SamyWarnants/Display-Project/Images/boardpic1.jpg

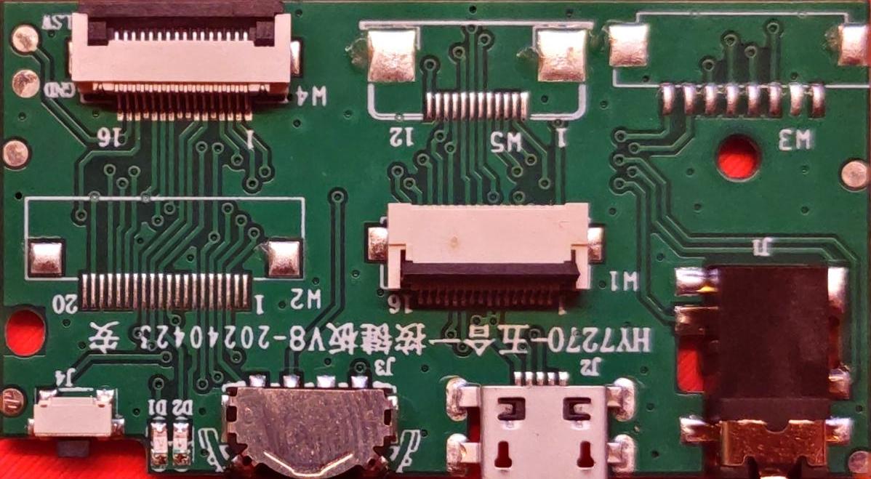
Images/boardpic1.jpg
