SamyWarnants/Display-Project/Images/boardtranslation.png

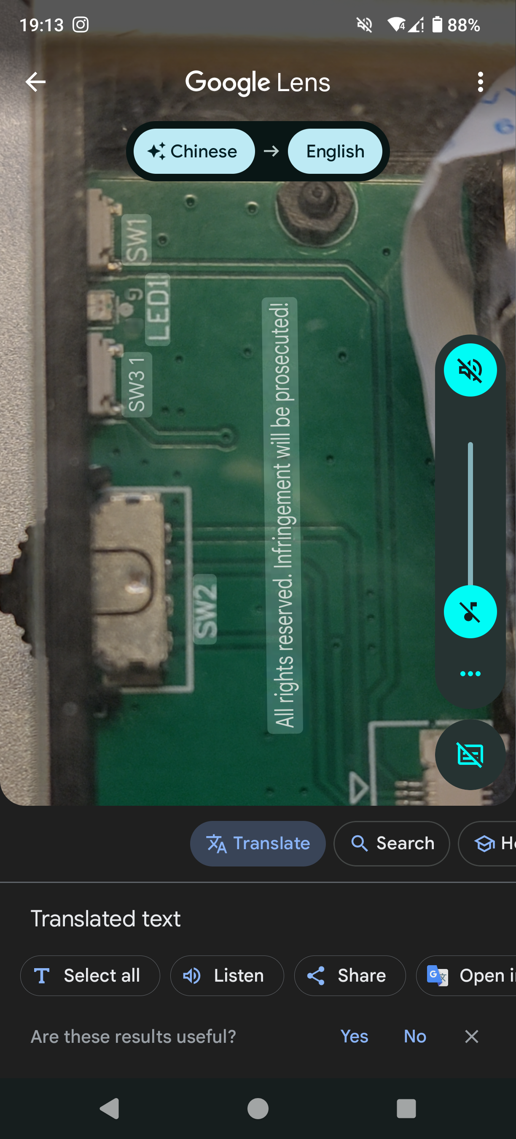
Images/boardtranslation.png
