SamyWarnants/Display-Project/Images/eindresultaatgen2.jpg

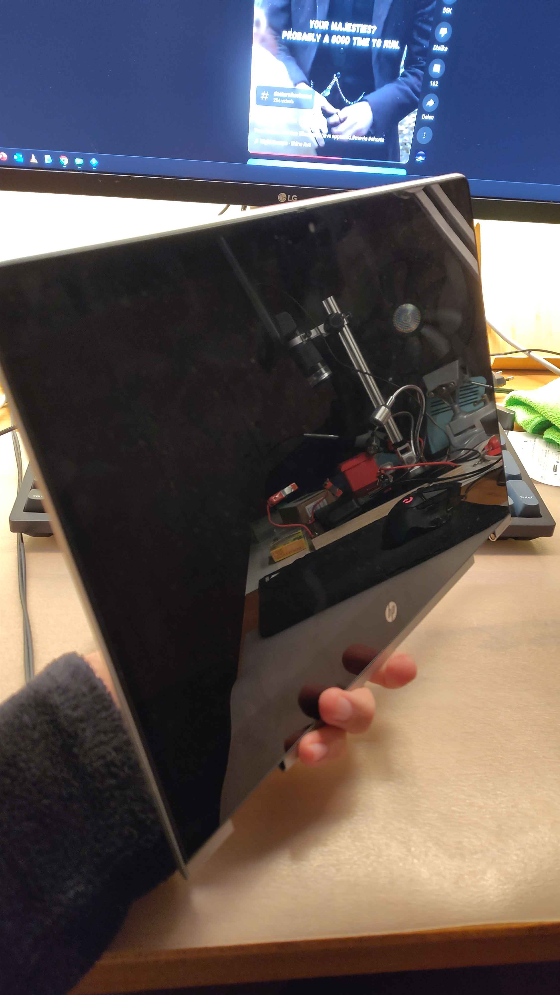
Images/eindresultaatgen2.jpg
