SamyWarnants/Display-Project/Images/missingping.jpg

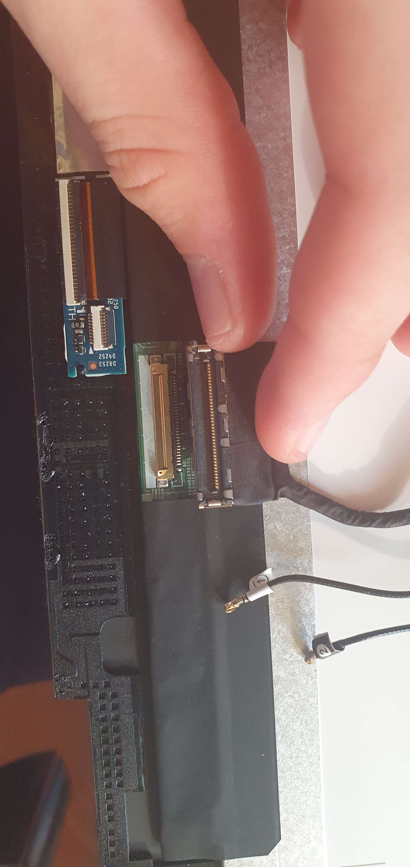
Images/missingping.jpg
