SamyWarnants/Display-Project/Images/plexialternative.jpg

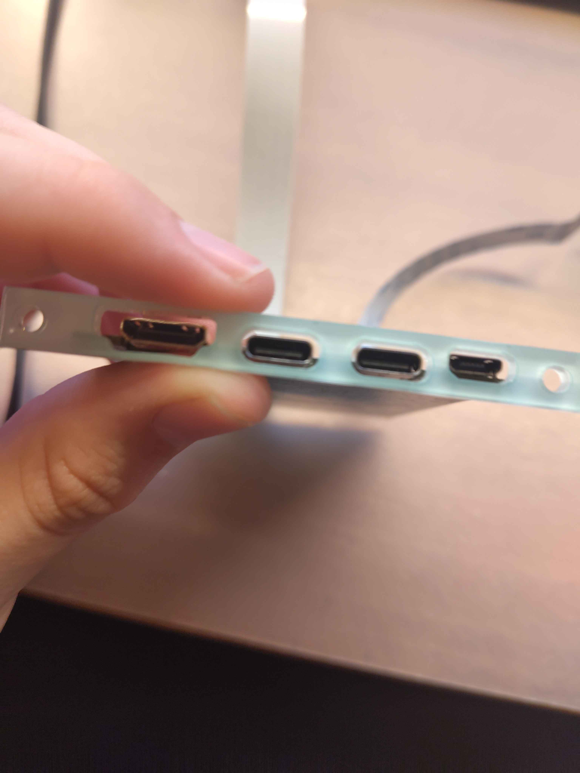
Images/plexialternative.jpg
