SamyWarnants/Display-Project/Generation1/adjustmentsysteem.3mf

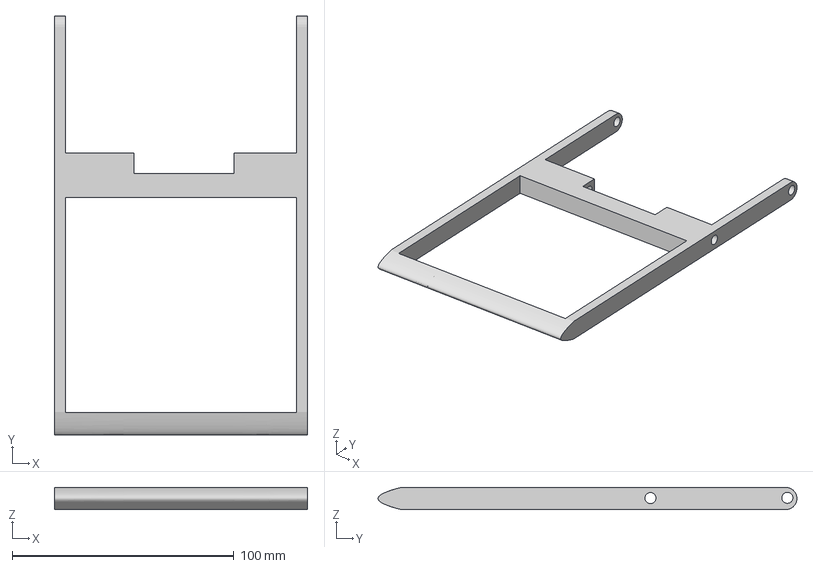
[picture p9: CAD file, 2025-09-27]
Generation1/adjustmentsysteem.3mf
114.1 x 188.9 x 10.0 mm
