SamyWarnants/Display-Project/Generation2/screenadjustmentv3.3mf

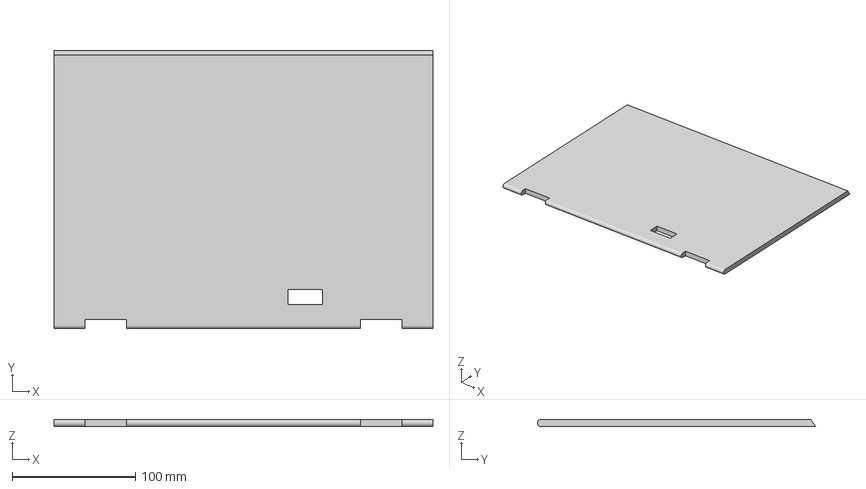
[picture p10: CAD file, 2025-09-27]
Generation2/screenadjustmentv3.3mf
307.0 x 225.5 x 5.82 mm
