SamyWarnants/Display-Project/Generation1/penholder.3mf

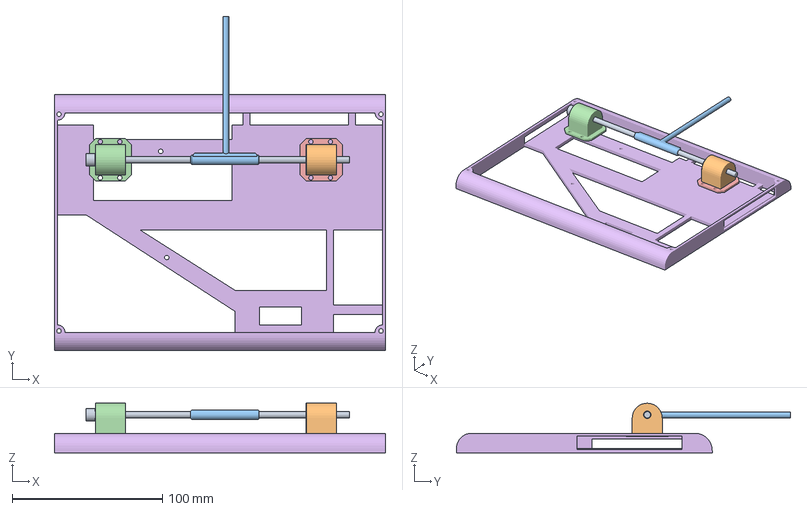
[picture p11: CAD file, 2025-09-27]
Generation1/penholder.3mf
220.0 x 222.0 x 33.0 mm
