SamyWarnants/Display-Project/Generation2/handle.3mf

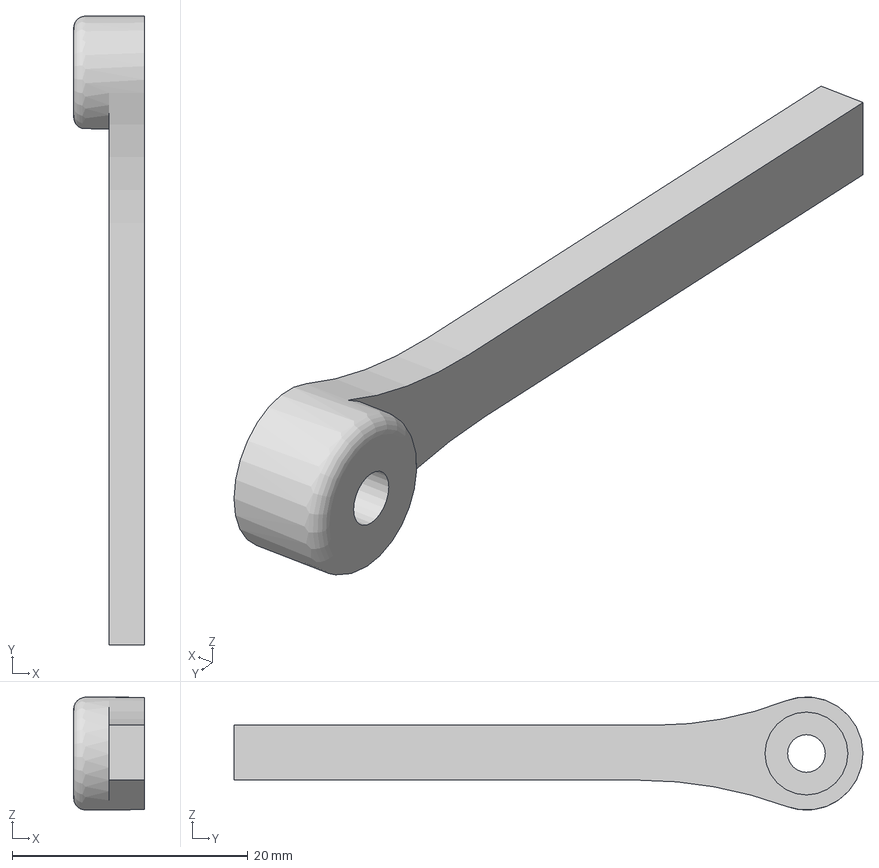
[picture p12: CAD file, 2025-09-27]
Generation2/handle.3mf
6.00 x 53.4 x 9.58 mm
