SamyWarnants/Display-Project/Generation1/magnethouderpoging2.3mf

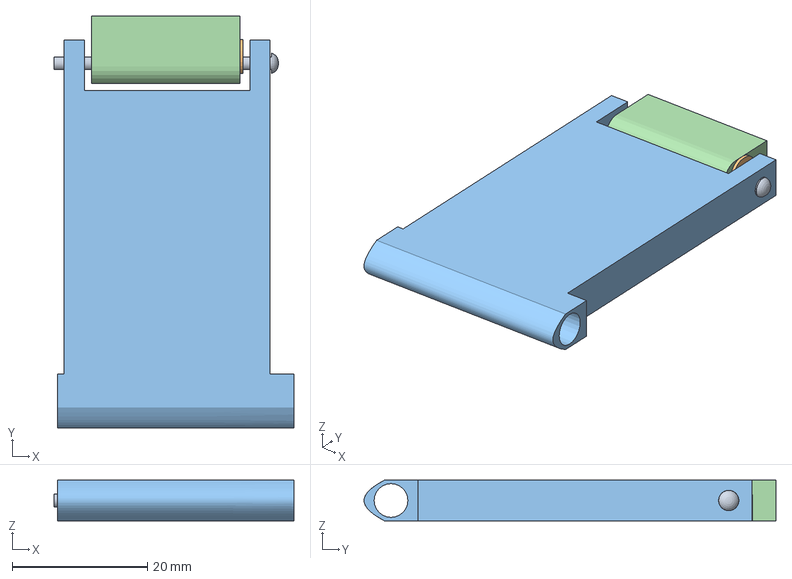
[picture p13: CAD file, 2025-09-27]
Generation1/magnethouderpoging2.3mf
35.5 x 61.0 x 6.00 mm
