SamyWarnants/Display-Project/Generation2/Hingetest.3mf

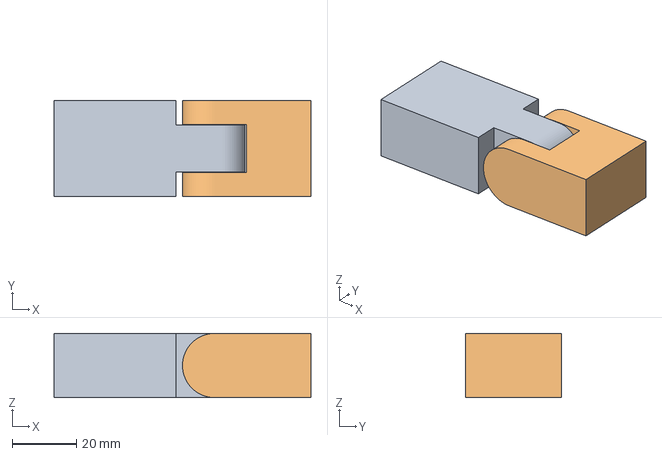
[picture p14: CAD file, 2025-09-27]
Generation2/Hingetest.3mf
80.0 x 30.0 x 20.0 mm
