SamyWarnants/Display-Project/Generation1/deksellasercut.3mf

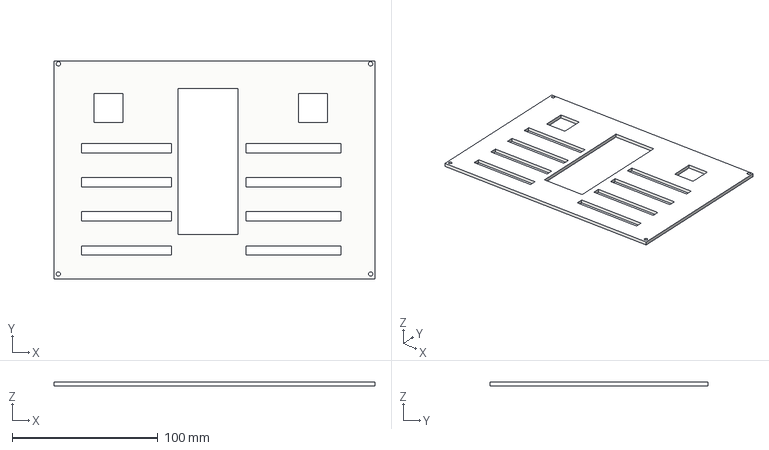
[picture p15: CAD file, 2025-09-27]
Generation1/deksellasercut.3mf
220.0 x 149.5 x 3.00 mm
