SamyWarnants/Display-Project/Generation2/controllerboard.3mf

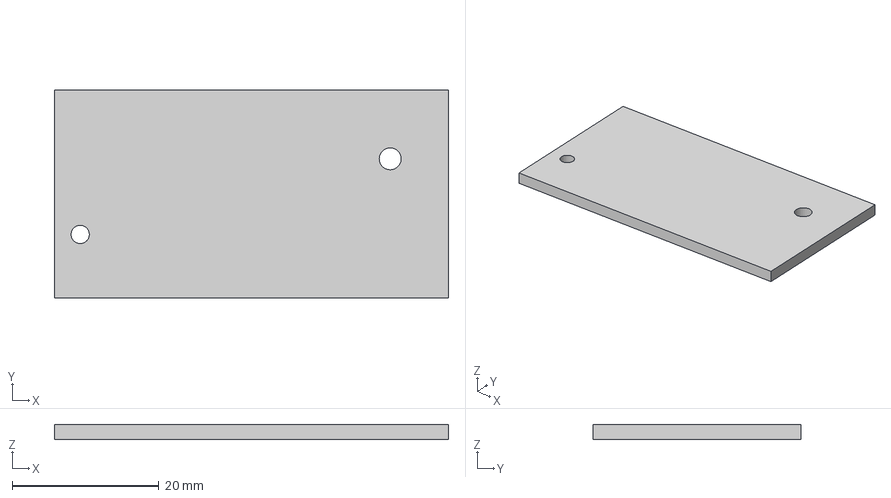
[picture p16: CAD file, 2025-09-27]
Generation2/controllerboard.3mf
53.8 x 28.4 x 2.00 mm
