SamyWarnants/Display-Project/Generation2/screenholder.3mf

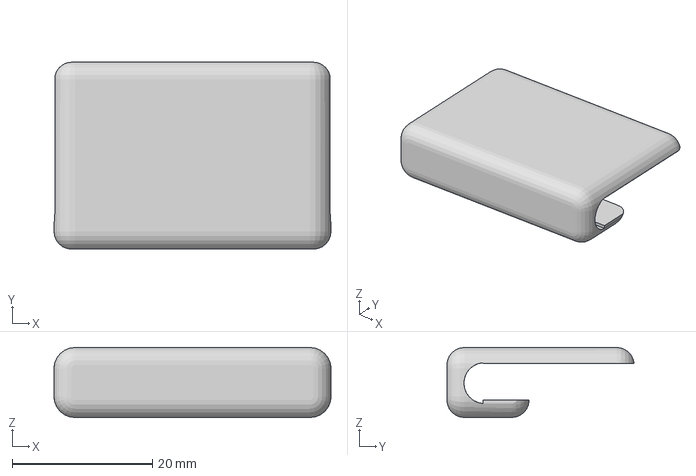
[picture p17: CAD file, 2025-09-27]
Generation2/screenholder.3mf
39.5 x 26.7 x 10.0 mm
