SamyWarnants/Display-Project/Generation2/newpcbholderrevision.3mf

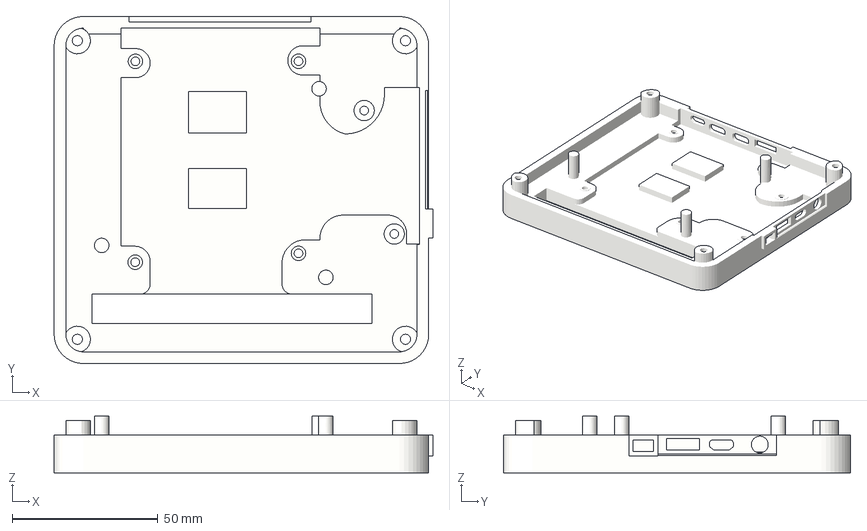
[picture p18: CAD file, 2025-09-27]
Generation2/newpcbholderrevision.3mf
129.9 x 119.0 x 19.5 mm
