SamyWarnants/Display-Project/Generation1/newscreenholder.3mf

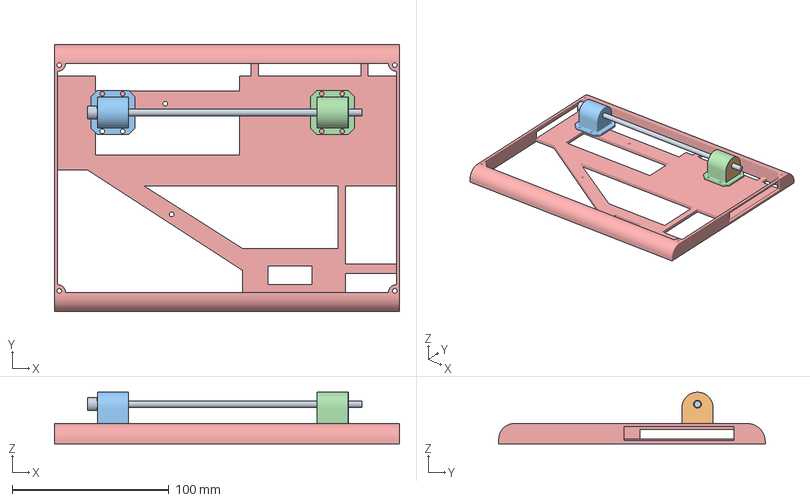
[picture p19: CAD file, 2025-09-27]
Generation1/newscreenholder.3mf
220.0 x 170.0 x 33.0 mm
