SamyWarnants/Display-Project/Generation2/Dekselscherm.3mf

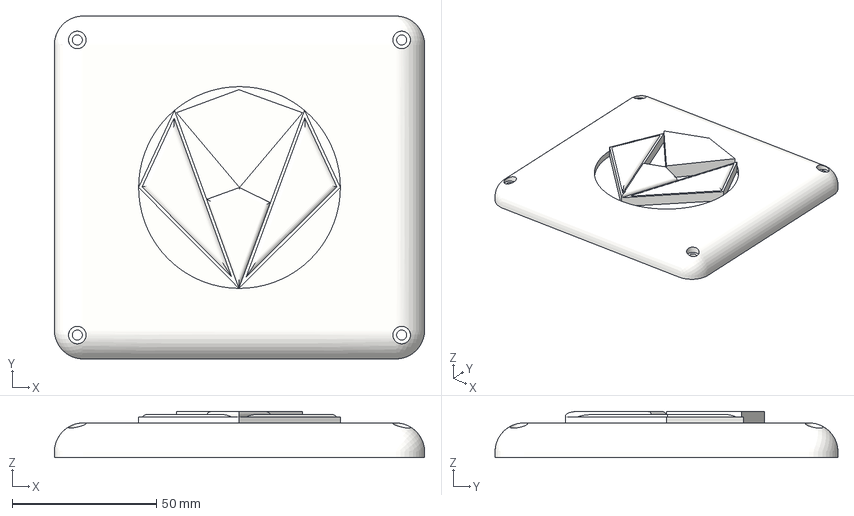
[picture p20: CAD file, 2025-09-27]
Generation2/Dekselscherm.3mf
128.5 x 119.0 x 16.0 mm
