SamyWarnants/Display-Project/Generation1/holderpcb.3mf

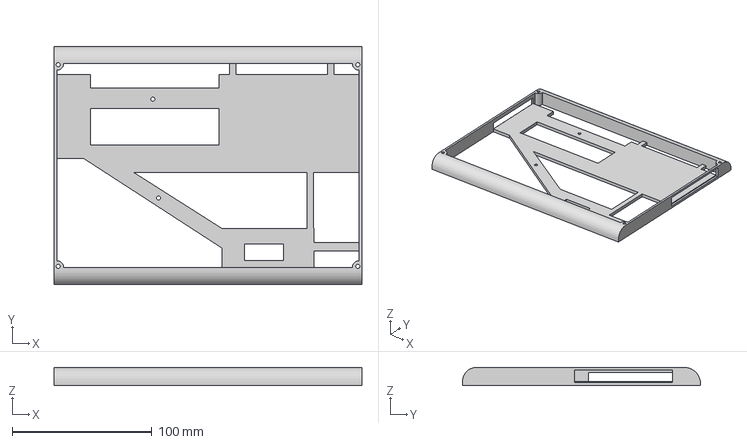
[picture p21: CAD file, 2025-09-27]
Generation1/holderpcb.3mf
220.0 x 170.0 x 13.0 mm
