SamyWarnants/Display-Project/Generation2/controllerboardwithinterface.3mf

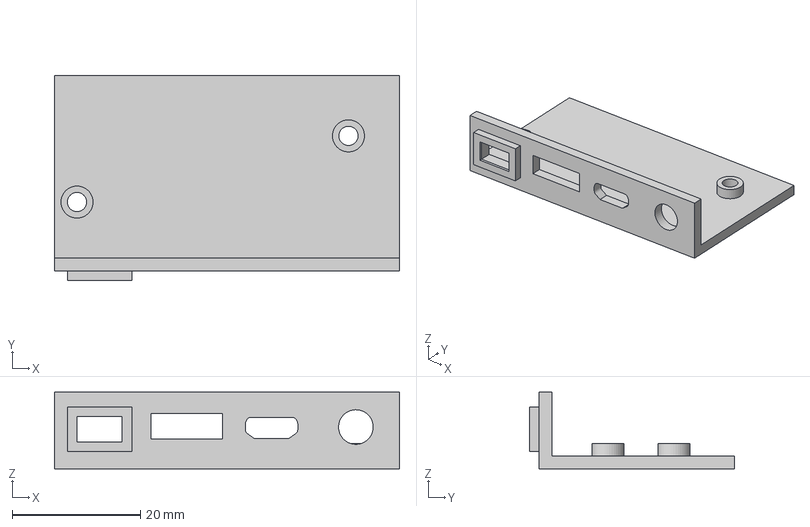
[picture p22: CAD file, 2025-09-27]
Generation2/controllerboardwithinterface.3mf
53.8 x 32.0 x 12.0 mm
