SamyWarnants/Display-Project/Generation1/deksel.3mf

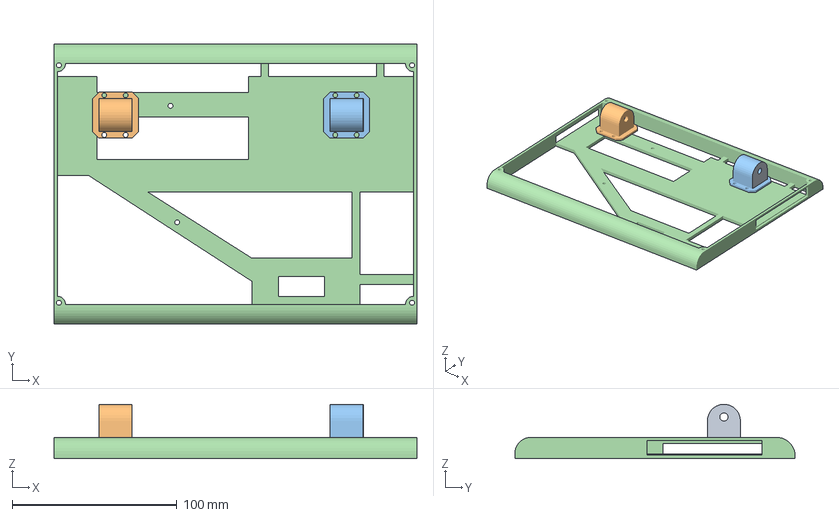
[picture p23: CAD file, 2025-09-27]
Generation1/deksel.3mf
220.0 x 170.0 x 33.0 mm
