SamyWarnants/Display-Project/Generation2/usbplate.3mf

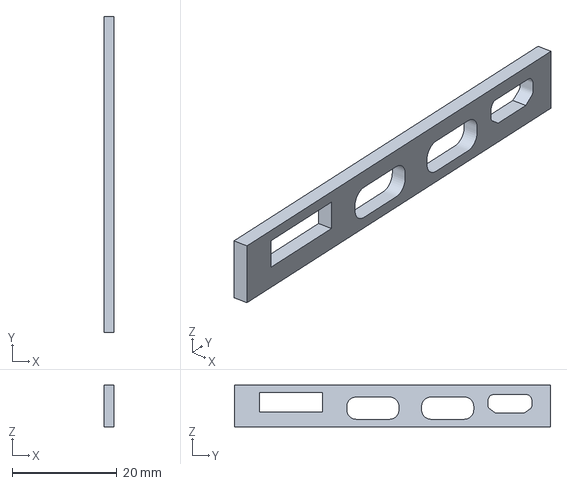
[picture p24: CAD file, 2025-09-27]
Generation2/usbplate.3mf
2.00 x 60.2 x 8.00 mm
