SamyWarnants/Display-Project/Generation1/adjustmentsystemmiddle.3mf

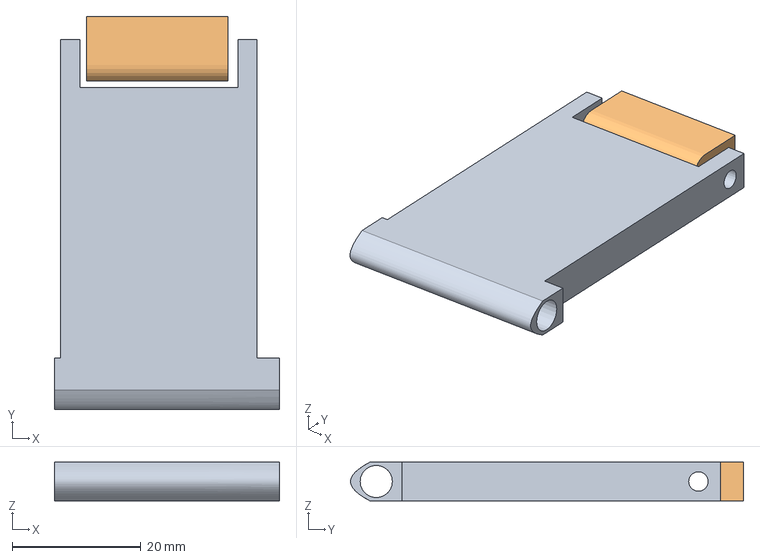
[picture p25: CAD file, 2025-09-27]
Generation1/adjustmentsystemmiddle.3mf
35.0 x 61.0 x 6.00 mm
