SamyWarnants/Display-Project/Generation2/closinglid.3mf

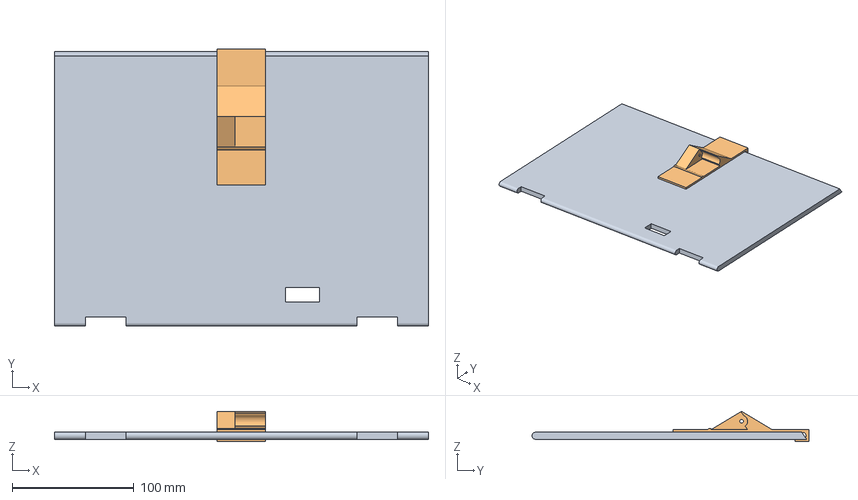
[picture p26: CAD file, 2025-09-27]
Generation2/closinglid.3mf
307.0 x 227.5 x 25.0 mm
