SamyWarnants/Display-Project/Generation2/buttoninterface.3mf

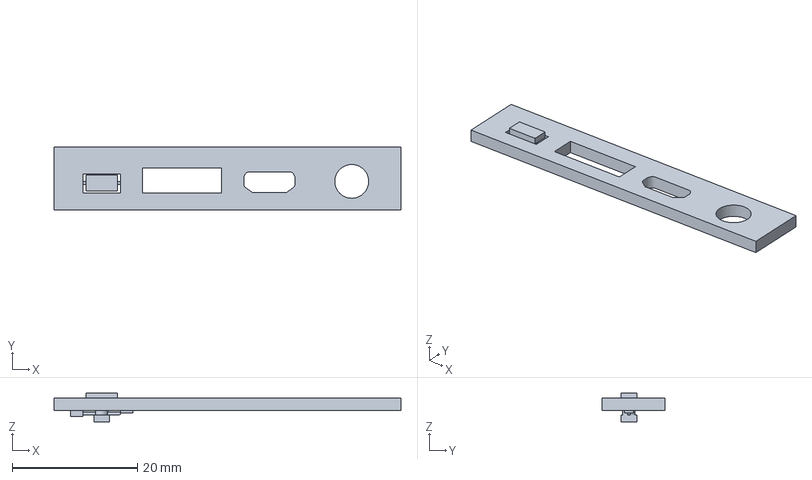
[picture p27: CAD file, 2025-09-27]
Generation2/buttoninterface.3mf
55.4 x 10.0 x 4.60 mm
