SamyWarnants/Display-Project/Generation2/boardholder.3mf

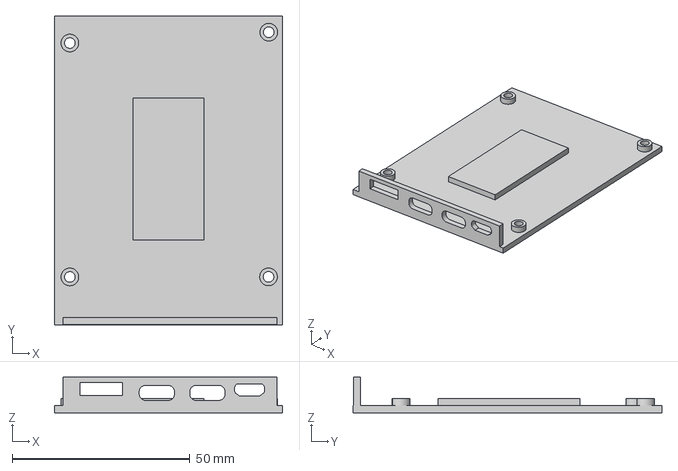
[picture p28: CAD file, 2025-09-27]
Generation2/boardholder.3mf
64.2 x 86.9 x 10.0 mm
