SamyWarnants/Display-Project/Generation2/screenclips.3mf

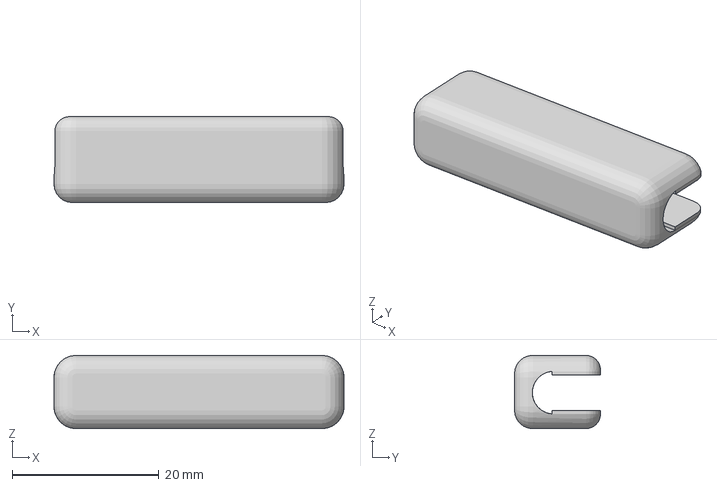
[picture p29: CAD file, 2025-09-27]
Generation2/screenclips.3mf
39.5 x 11.7 x 10.0 mm
