SamyWarnants/Display-Project/Generation2/screenadjustments.3mf

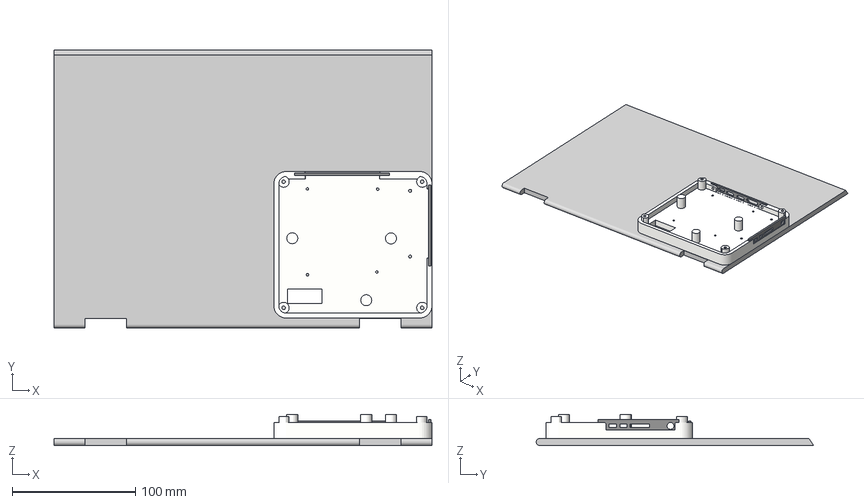
[picture p30: CAD file, 2025-09-27]
Generation2/screenadjustments.3mf
307.0 x 225.5 x 25.3 mm
