SamyWarnants/Display-Project/Generation2/tpubuttoncatcher.3mf

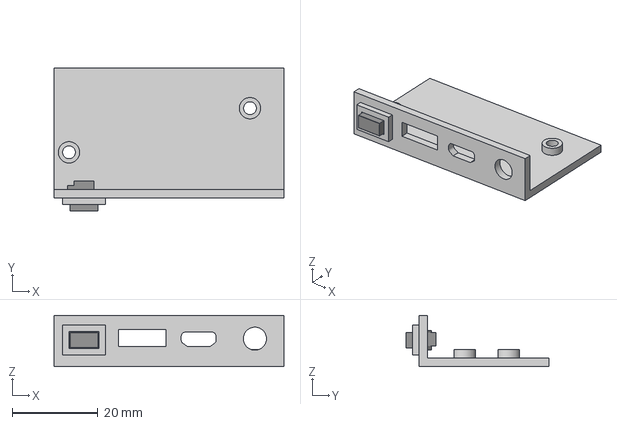
[picture p31: CAD file, 2025-09-27]
Generation2/tpubuttoncatcher.3mf
53.8 x 33.5 x 12.0 mm
