SamyWarnants/Display-Project/(list of files, cad)

Other CAD files:
Generation1/digitalversionvanhetscherm.3mf
Generation1/adjustmentsysteemv2.3mf
Generation2/digitalversionvanhetscherm.3mf
Generation2/new screen adjustmentsystem.3mf
Generation1/adjustmentsysteem.obj
Generation1/adjustmentsysteem.stl
Generation1/adjustmentsysteemv2.obj
Generation1/adjustmentsysteemv2.stl
Generation1/adjustmentsystemmiddle.obj
Generation1/adjustmentsystemmiddle.stl
Generation1/deksel.obj
Generation1/deksel.stl
Generation1/deksellasercut.obj
Generation1/deksellasercut.stl
Generation1/digitalversionvanhetscherm.obj
Generation1/digitalversionvanhetscherm.stl
Generation1/holderpcb.obj
Generation1/holderpcb.stl
Generation1/magnethouderpoging2.obj
Generation1/magnethouderpoging2.stl
Generation1/newscreenholder.obj
Generation1/newscreenholder.stl
Generation1/penholder.obj
Generation1/penholder.stl
Generation2/Dekselscherm.obj
Generation2/Dekselscherm.stl
Generation2/Hingetest.obj
Generation2/Hingetest.stl
Generation2/boardholder.obj
Generation2/boardholder.stl
Generation2/buttoninterface.obj
Generation2/buttoninterface.stl
Generation2/closinglid.obj
Generation2/closinglid.stl
Generation2/controllerboard.obj
Generation2/controllerboard.stl
Generation2/controllerboardwithinterface.obj
Generation2/controllerboardwithinterface.stl
Generation2/digitalversionvanhetscherm.obj
Generation2/digitalversionvanhetscherm.stl
Generation2/handle.obj
Generation2/handle.stl
Generation2/new screen adjustmentsystem.obj
Generation2/new screen adjustmentsystem.stl
Generation2/newpcbholderrevision.obj
Generation2/newpcbholderrevision.stl
Generation2/screenadjustments.obj
Generation2/screenadjustments.stl
Generation2/screenadjustmentv3.obj
Generation2/screenadjustmentv3.stl
Generation2/screenclips.obj
Generation2/screenclips.stl
Generation2/screenholder.obj
Generation2/screenholder.stl
Generation2/tpubuttoncatcher.obj
Generation2/tpubuttoncatcher.stl
Generation2/usbplate.obj
Generation2/usbplate.stl
