SamyWarnants/Display-Project/(commit log)

2025-09-27 Adding the files
    Starting by adding all the files. Images, models and pythonscript
    [Dekselscherm.3mf, Dekselscherm.obj, Dekselscherm.stl, Hingetest.3mf, Hingetest.obj, Hingetest.stl, adjustmentsysteem.3mf, adjustmentsysteem.obj]
2025-09-30 Updated the repo a bit
    too much to mention
    [Dekselscherm.3mf, Dekselscherm.obj, Dekselscherm.stl, Hingetest.3mf, Hingetest.obj, Hingetest.stl, adjustmentsysteem.3mf, adjustmentsysteem.obj]
